Neotron-Compute/codec-test-nau88c22/README.md

# NAU88C22 CODEC Test PCB

This is a PCB for testing the [Nuvoton NAU88C22 CODEC chip].

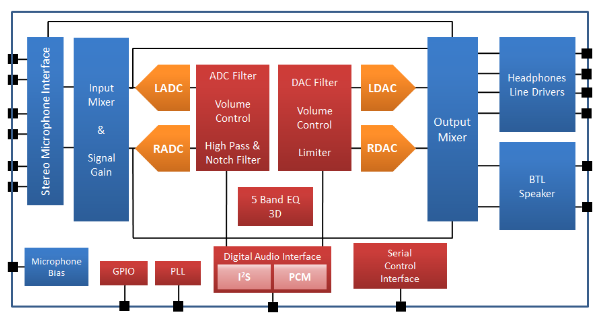
[picture p1: block-diagram.png]
A block diagram of the NAU88C22


[Nuvoton NAU88C22 CODEC chip]: https://www.nuvoton.com/products/smart-home-audio/audio-converters/audio-codec-series/nau88c22yg/
