Neotron-Compute/codec-test-nau88c22/PJ-320D-A--3DModel-STEP-56544.STEP

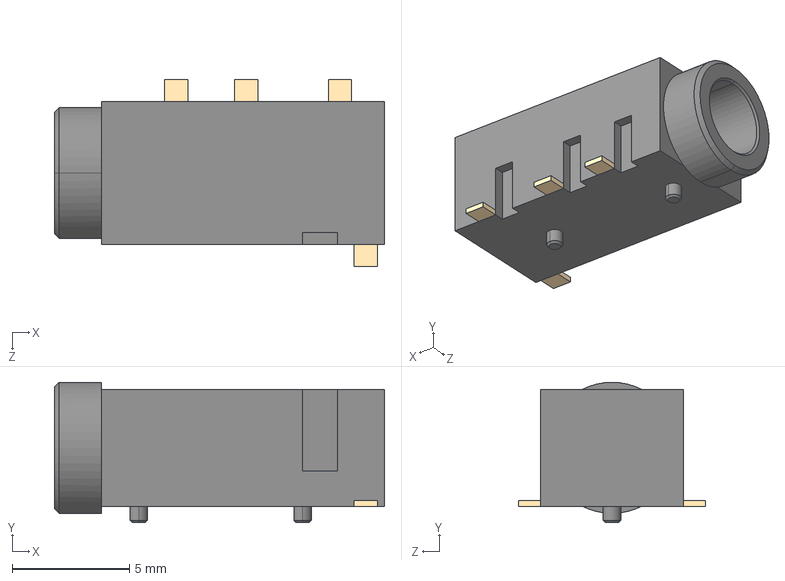
[picture p2: CAD file, 2023-11-25]
PJ-320D-A--3DModel-STEP-56544.STEP
14.1 x 6.00 x 8.00 mm
