Neotron-Compute/codec-test-nau88c22/codec-test-nau88c22.kicad_pcb

## KiCad design codec-test-nau88c22.kicad_pcb (2023-11-25)

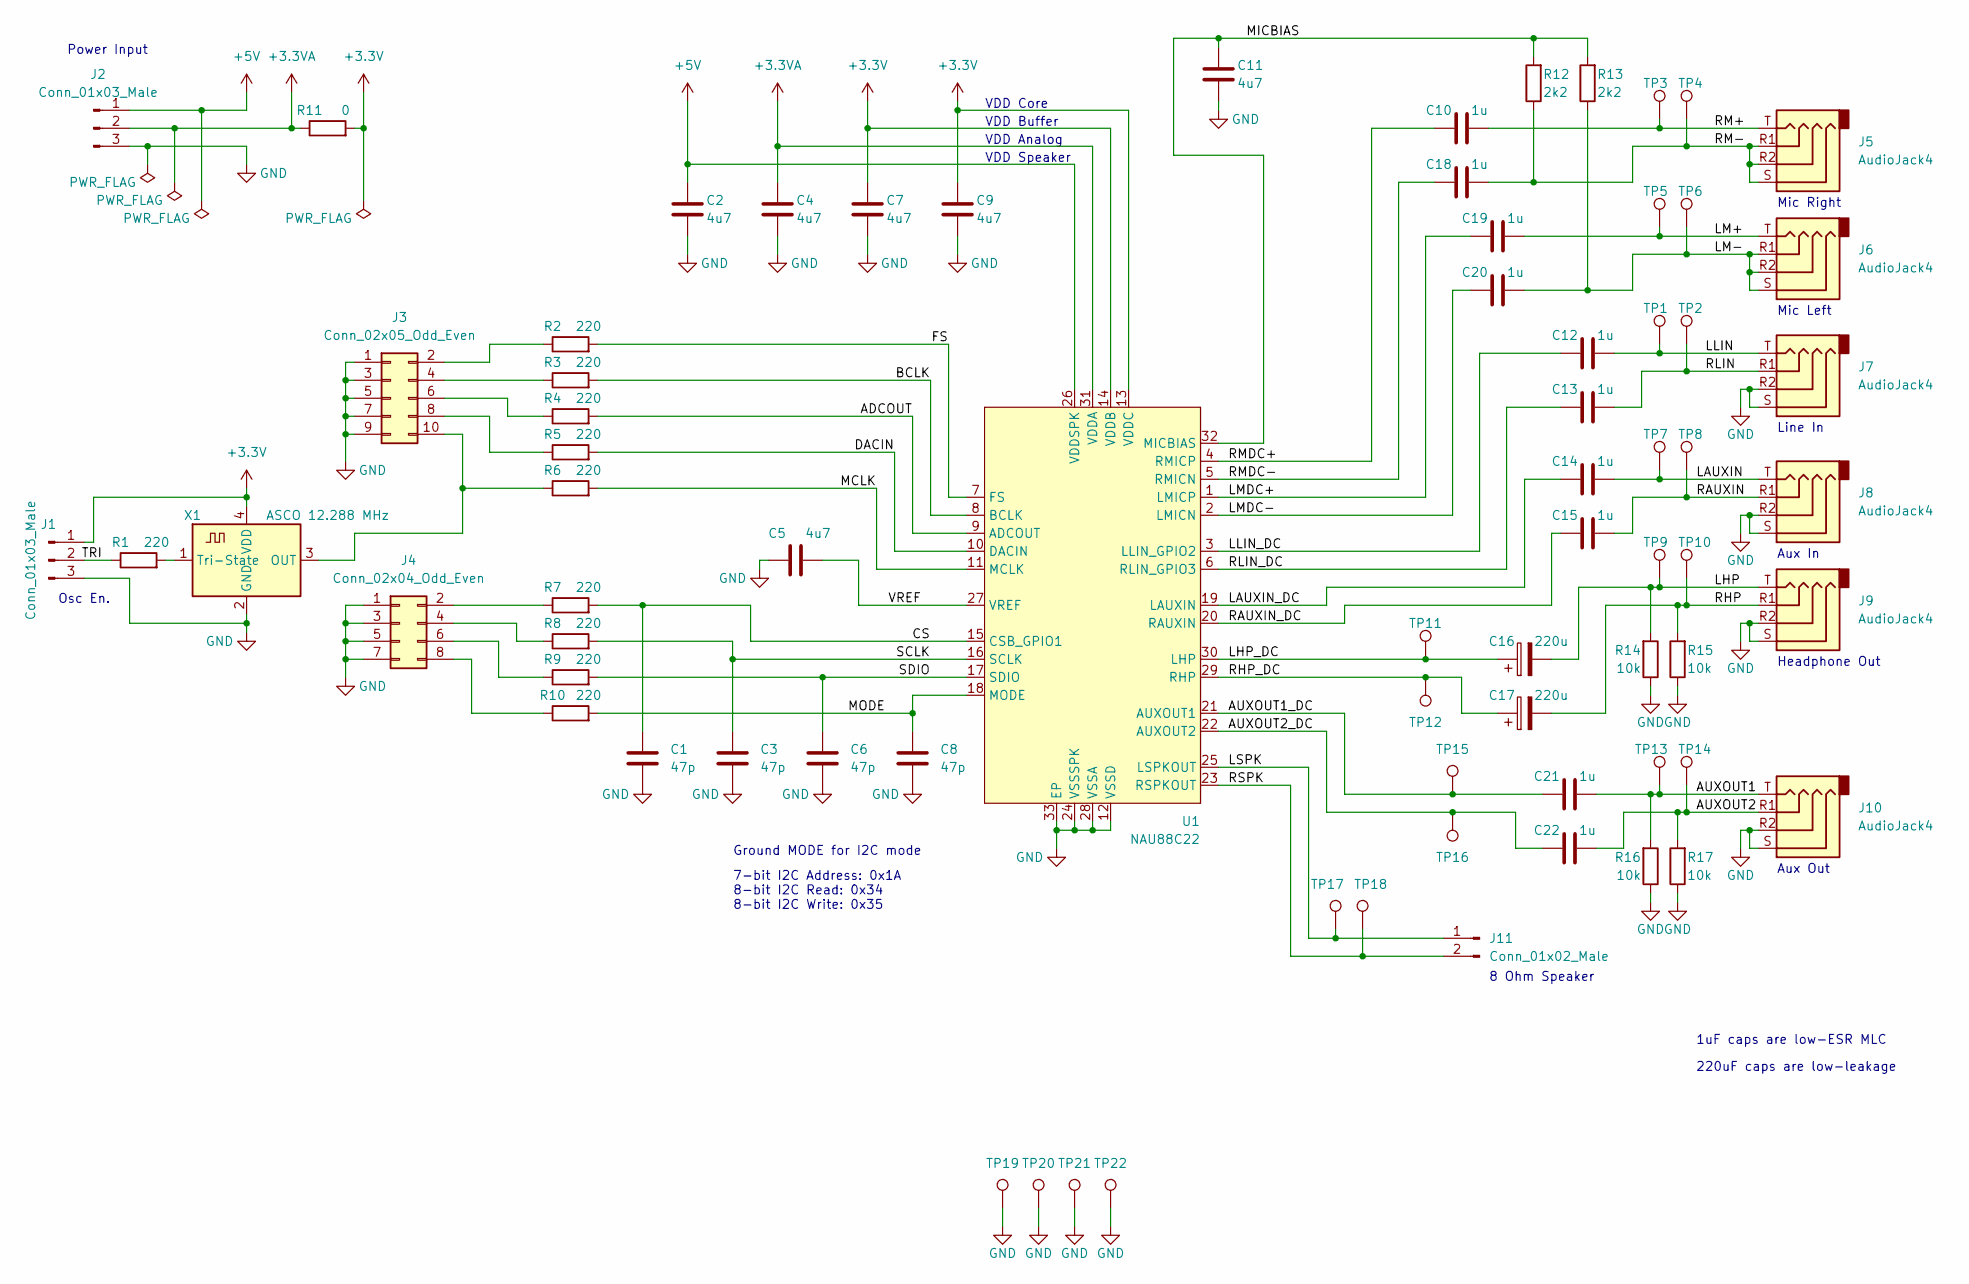
[picture p3: schematic codec-test-nau88c22.kicad_sch, Codec Test NAU88C22]

Parts:
C1, C3, C6, C8: 47p; C_0805_2012Metric; Part No CL21C470JBANNNC; LCSC Part# C14857
C2, C4, C5, C7, C9, C11: 4u7; C_0805_2012Metric; Part No CL21A475KAQNNNE; LCSC Part# C1779
C10, C12, C13, C14, C15, C18, C19, C20, C21, C22: 1u; C_0805_2012Metric; Part No CL21B105KBFNNNE; LCSC Part# C28323
C16, C17: 220u; CP_Elec_10x10; Part No UWT1H221MNL1GS; LCSC Part# C125977
J1, J2: Conn_01x03_Male; PinHeader_1x03_P2.54mm_Vertical
J3: Conn_02x05_Odd_Even; PinHeader_2x05_P2.54mm_Vertical
J4: Conn_02x04_Odd_Even; PinHeader_2x04_P2.54mm_Vertical
J5, J6, J7, J8, J9, J10: AudioJack4; Jack_3.5mm_PJ320D_Horizontal; Part No PJ-320D; LCSC Part# C431535
J11: Conn_01x02_Male; PinHeader_1x02_P2.54mm_Vertical
R1, R2, R3, R4, R5, R6, R7, R8, R9, R10: 220; R_0805_2012Metric; Part No 0805W8F2200T5E; LCSC Part# C17557
R11: 0; R_0805_2012Metric; Part No 0805W8F0000T5E; LCSC Part# C17477
R12, R13: 2k2; R_0805_2012Metric; Part No 0805W8F2201T5E; LCSC Part# C17520
R14, R15, R16, R17: 10k; R_0805_2012Metric; Part No 0805W8F1002T5E; LCSC Part# C17414
TP1, TP2, TP3, TP4, TP5, TP6, TP7, TP8, TP9, TP10, TP11, TP12, TP13, TP14, TP15, TP16, TP17, TP18, TP19, TP20, TP21, TP22: TestPoint; TestPoint_THTPad_2.0x2.0mm_Drill1.0mm
U1: NAU88C22; VQFN-32-1EP_5x5mm_P0.5mm_EP3.5x3.5mm; Part No NAU88C22YG; LCSC Part# C914209
X1: ASCO 12.288 MHz; Oscillator_SMD_Abracon_ASE-4Pin_3.2x2.5mm_HandSoldering; Part No OT2EL4C4JI-111OLP-12.288M; LCSC Part# C5203546

Connections:
+3.3V: C7.1, C9.1, J1.1, R11.2, U1.13 (VDDC), U1.14 (VDDB), X1.4 (VDD)
+3.3VA: C4.1, J2.2, R11.1, U1.31 (VDDA)
+5V: C2.1, J2.1, U1.26 (VDDSPK)
/ADCOUT: R4.2, U1.9 (ADCOUT)
/AUXOUT1: C21.2, J10.T, R16.2, TP13.1
/AUXOUT1_DC: C21.1, TP15.1, U1.21 (AUXOUT1)
/AUXOUT2: C22.2, J10.R1, R17.2, TP14.1
/AUXOUT2_DC: C22.1, TP16.1, U1.22 (AUXOUT2)
/BCLK: R3.2, U1.8 (BCLK)
/CS: C1.1, R7.2, U1.15 (CSB_GPIO1)
/DACIN: R5.2, U1.10 (DACIN)
/FS: R2.2, U1.7 (FS)
/LAUXIN: C14.2, J8.T, TP7.1
/LAUXIN_DC: C14.1, U1.19 (LAUXIN)
/LHP: C16.2, J9.T, R14.2, TP9.1
/LHP_DC: C16.1, TP11.1, U1.30 (LHP)
/LLIN: C12.2, J7.T, TP1.1
/LLIN_DC: C12.1, U1.3 (LLIN_GPIO2)
/LM+: C19.2, J6.T, TP5.1
/LM-: C20.2, J6.R1, J6.R2, J6.S, R13.1, TP6.1
/LMDC+: C19.1, U1.1 (LMICP)
/LMDC-: C20.1, U1.2 (LMICN)
/LSPK: J11.1, TP17.1, U1.25 (LSPKOUT)
/MCLK: R6.2, U1.11 (MCLK)
/MICBIAS: C11.1, R12.2, R13.2, U1.32 (MICBIAS)
/MODE: C8.1, R10.2, U1.18 (MODE)
/RAUXIN: C15.2, J8.R1, TP8.1
/RAUXIN_DC: C15.1, U1.20 (RAUXIN)
/RHP: C17.2, J9.R1, R15.2, TP10.1
/RHP_DC: C17.1, TP12.1, U1.29 (RHP)
/RLIN: C13.2, J7.R1, TP2.1
/RLIN_DC: C13.1, U1.6 (RLIN_GPIO3)
/RM+: C10.2, J5.T, TP3.1
/RM-: C18.2, J5.R1, J5.R2, J5.S, R12.1, TP4.1
/RMDC+: C10.1, U1.4 (RMICP)
/RMDC-: C18.1, U1.5 (RMICN)
/RSPK: J11.2, TP18.1, U1.23 (RSPKOUT)
/SCLK: C3.1, R8.2, U1.16 (SCLK)
/SDIO: C6.1, R9.2, U1.17 (SDIO)
/TRI: J1.2, R1.1
/VREF: C5.1, U1.27 (VREF)
GND: C1.2, C2.2, C3.2, C4.2, C5.2, C6.2, C7.2, C8.2, C9.2, C11.2, J1.3, J2.3, J3.1, J3.3, J3.5, J3.7, J3.9, J4.1, J4.3, J4.5, J4.7, J7.R2, J7.S, J8.R2, J8.S, J9.R2, J9.S, J10.R2, J10.S, R14.1, R15.1, R16.1, R17.1, TP19.1, TP20.1, TP21.1, TP22.1, U1.12 (VSSD), U1.24 (VSSSPK), U1.28 (VSSA), U1.33 (EP), X1.2 (GND)
unnamed: J3.2, R2.1
unnamed: J3.4, R3.1
unnamed: J3.6, R4.1
unnamed: J3.8, R5.1
unnamed: J3.10, R6.1, X1.3 (OUT)
unnamed: J4.2, R7.1
unnamed: J4.4, R8.1
unnamed: J4.6, R9.1
unnamed: J4.8, R10.1
unnamed: R1.2, X1.1 (Tri-State)

Notes on the sheet:
1uF caps are low-ESR MLC
Mic Right
Mic Left
Aux Out
7-bit I2C Address: 0x1A 8-bit I2C Read: 0x34 8-bit I2C Write: 0x35
VDD Analog
Headphone Out
Osc En.
Aux In
VDD Buffer
220uF caps are low-leakage
Power Input
8 Ohm Speaker
VDD Speaker
Line In
VDD Core
Ground MODE for I2C mode

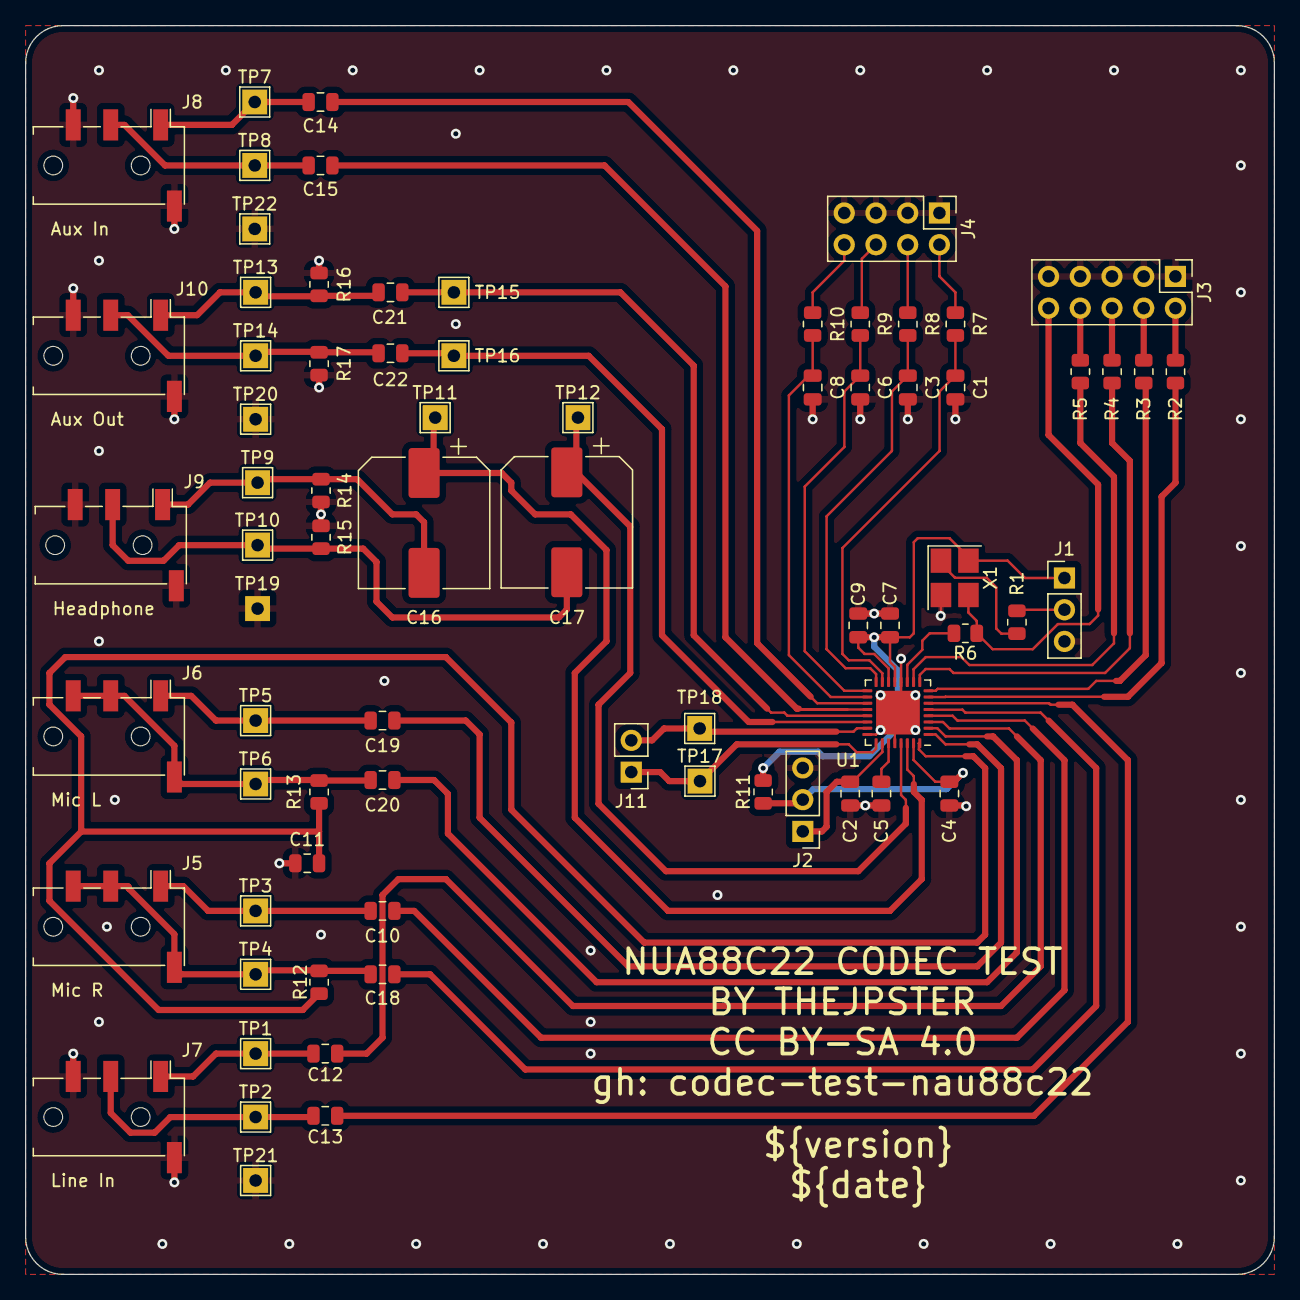
[picture p4: board codec-test-nau88c22.kicad_pcb from above]

Board: 2 copper layers, 100.0 x 100.0 mm, 73 parts (0 on the bottom side), 52 nets.
