Neotron-Compute/codec-test-nau88c22/(commit log)

2023-11-25 First version
    [codec-test-nau88c22.kicad_pcb, codec-test-nau88c22.kicad_sch]
2023-11-25 Rewired then updated kibot
    [PJ-320D-A--3DModel-STEP-56544.STEP, codec-test-nau88c22.kicad_pcb, codec-test-nau88c22.kicad_sch]
2023-11-25 Fix DRC errors
    [codec-test-nau88c22.kicad_pcb]
2023-12-16 Test program for RP2040.
    Currently incomplete.
2023-12-27 Makes incredibly loud static.
    But at least it plays something! I also
    added a simple UART interface to interactively poke registers.
2023-12-27 OK you can play audio....
    But I had to 'break' the PIO code to look for clock signals being the wrong way up in order for it to work. I worry that the PIO code is being encoded wrong. That or I just really can't read an oscilloscope trace.
    [i2s.rs, main.rs]
2023-12-29 Use probe-rs-cli.
    It has a better progress bar.
2023-12-29 Use WAIT GPIO.
    Lower latency than wait pin, apparently.
2023-12-29 Loop sample.
2024-01-26 Updated to released version of driver.
