Neotron-Compute/codec-test-nau88c22/(notices)

Notices in the files:
codec-test-nau88c22.kicad_pcb:
CC BY-SA 4.0
codec-test-nau88c22.kicad_sch:
Licensed as CC-BY-SA
Copyright (c) The Neotron Developers, 2023
